SL-RU/svelotracker/pinout.xls

MCU_PIN | NAME
PA0 | K_WKUP | Sleep/wake up button
PA1 | P_VUIN | Voltage on USB
PA2 | P_IUIN | Current from USB to circuit
PA3 | P_VBAT | Voltage on batteries
PA4 | P_ISCH | Current from battaries to circuit
PA5 | L_SCK | LCD SPI
PA6 | L_MISO | LCD SPI
PA7 | L_MOSI | LCD SPI
PA8 | P_CHEN | Enable charging
PA9 | U_VBUS | USB
PA10 | U_ID | USB
PA11 | U_DM | USB
PA12 | U_DP | USB
PA13 | SWDIO | SWD debug
PA14 | SWCLK | SWD debug
PA15 | P_5VEN | Enable 5V booster & power on USB Vbus
PB0 | L_CS | LCD SPI CS
PB1 | L_LED | LCD Backlight
PB2 | P_STAT | Status of charger
PB3 | K_LATCH | Register SPI
PB4 | K_CLK | Register SPI
PB5 | K_DAT | Register SPI
PB6 | D_RX | Debug uart
PB7 | D_TX | Debug uart
PB8 | I2C1_SCL | I2C for EEPROM & COMPASS
PB9 | I2C1_SDA | I2C for EEPROM & COMPASS
PB10 | x
PB12 | C_INT2 | Compass
PB13 | C_RES | Compass
PB14 | C_INT1 | Compass
PB15 | G_RST | GPS Reset
PC0 | K_BUT1 | Button's matrix inputs
PC1 | K_BUT2 | Button's matrix inputs
PC2 | P_UFLT | USB power driver fault
PC3 | P_SHDN | Device shutdown trigger
PC4 | L_DC | LCD Data/Control
PC5 | L_RST | LCD Reset
PC6 | G_RX1 | GPS UART
PC7 | G_TX1 | GPS UART
PC8 | S_D0 | SD CARD
PC9 | S_D1 | SD CARD
PC10 | S_D2 | SD CARD
PC11 | S_D3 | SD CARD
PC12 | S_CLK | SD CARD
PC13 | x
PC14 | sys
PC15 | sys
D2 | S_CMD | SD CARD
