SL-RU/svelotracker/img/pcb1.png

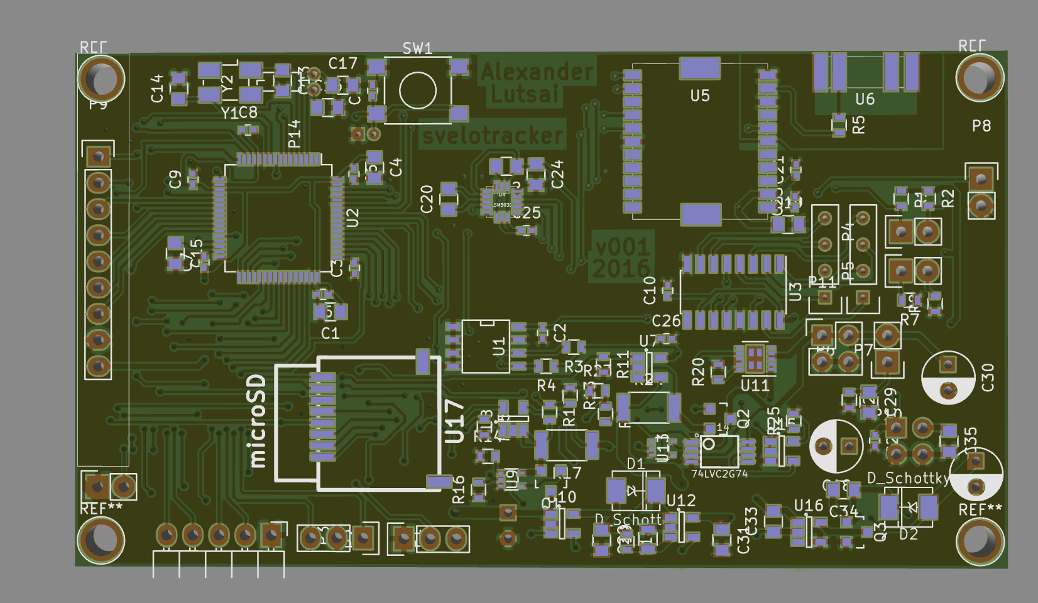
img/pcb1.png
