SL-RU/svelotracker/img/pcb2.png

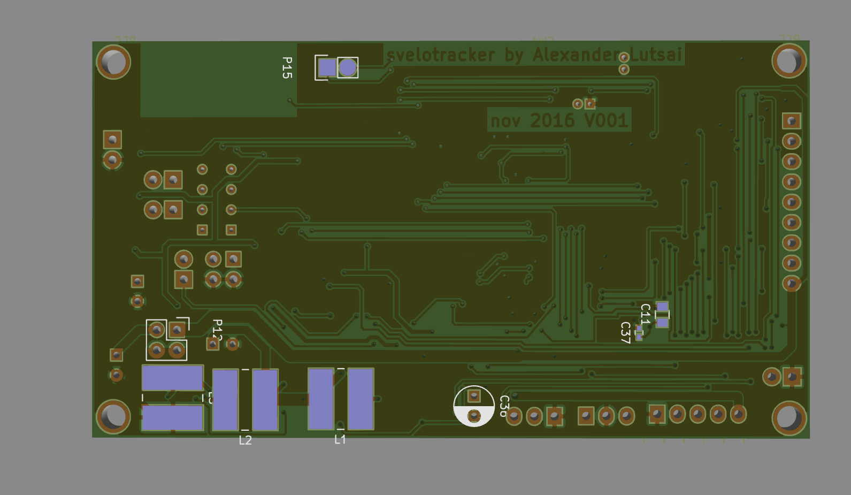
img/pcb2.png
