SL-RU/svelotracker/img/pcb3.png

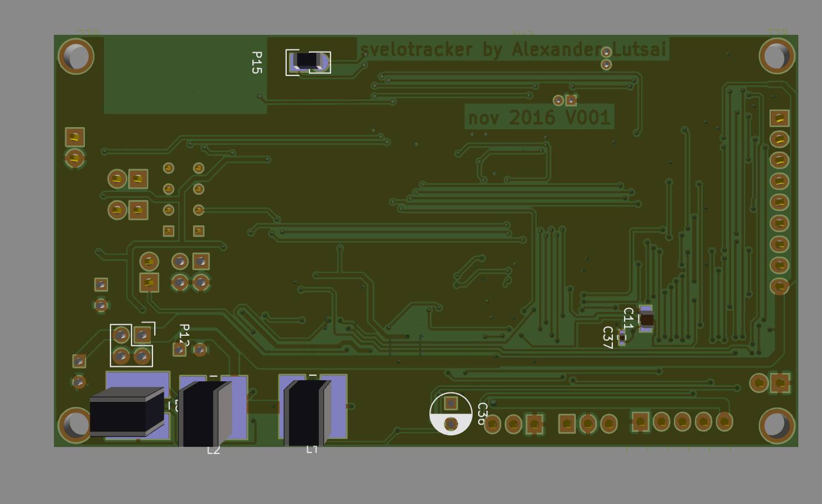
img/pcb3.png
