SL-RU/svelotracker/img/pcb4.png

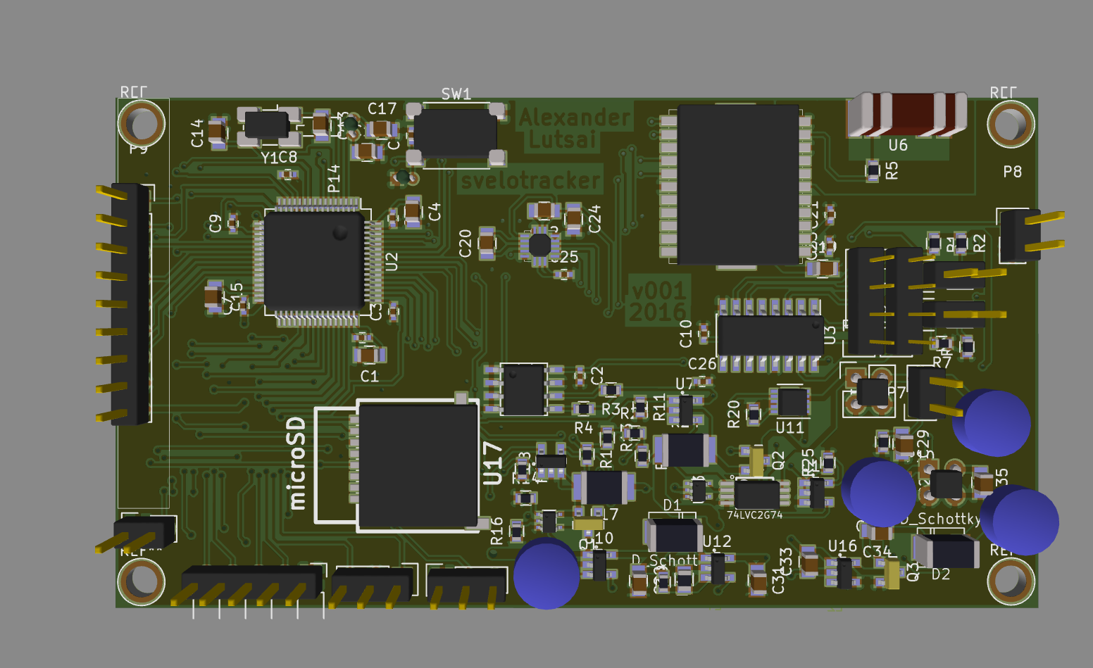
img/pcb4.png
