SL-RU/svelotracker/case/velotracker_microusb.stl

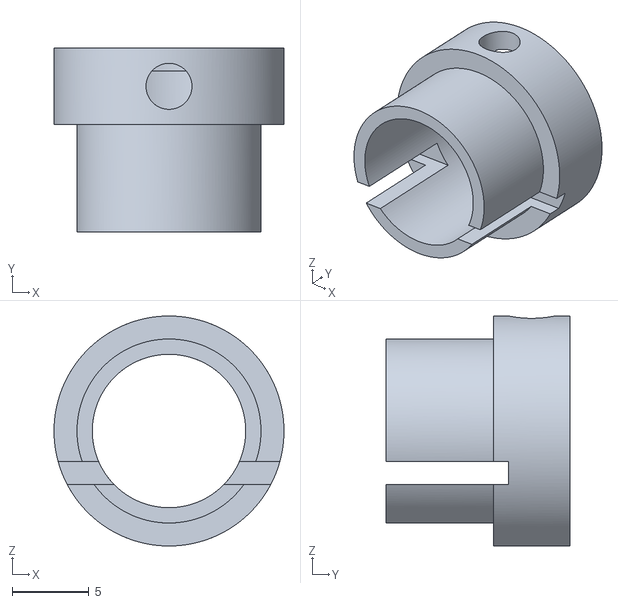
[picture p5: CAD file, 2017-02-20]
case/velotracker_microusb.stl
15.0 x 12.0 x 15.0
