SL-RU/svelotracker/datasheets/svelotracker2.stl

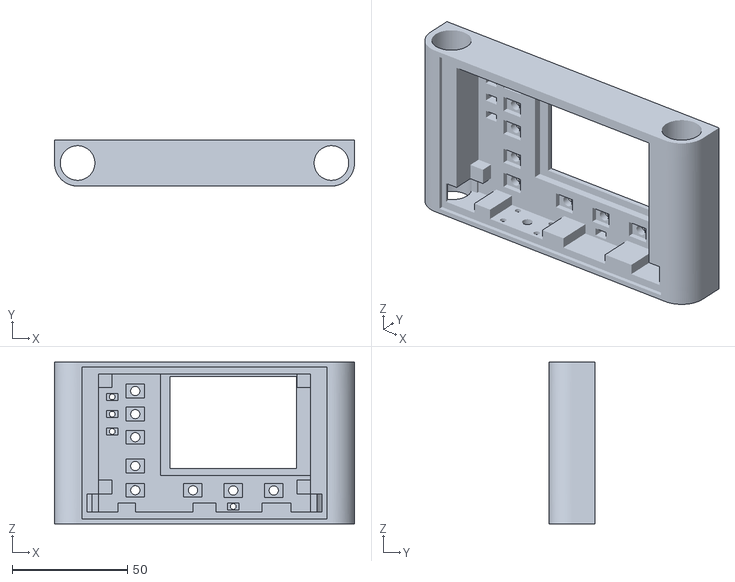
[picture p6: CAD file, 2017-02-20]
datasheets/svelotracker2.stl
130.0 x 20.0 x 70.0
