SL-RU/svelotracker/datasheets/velotracker.stl

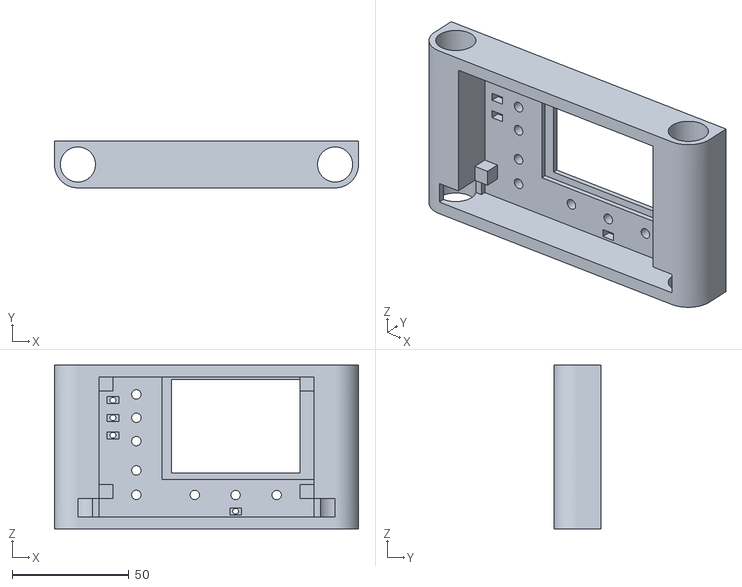
[picture p7: CAD file, 2017-02-20]
datasheets/velotracker.stl
130.0 x 20.0 x 70.0
