SL-RU/svelotracker/sch/sch.kicad_pcb

## KiCad design sch/sch.kicad_pcb (2017-02-20)

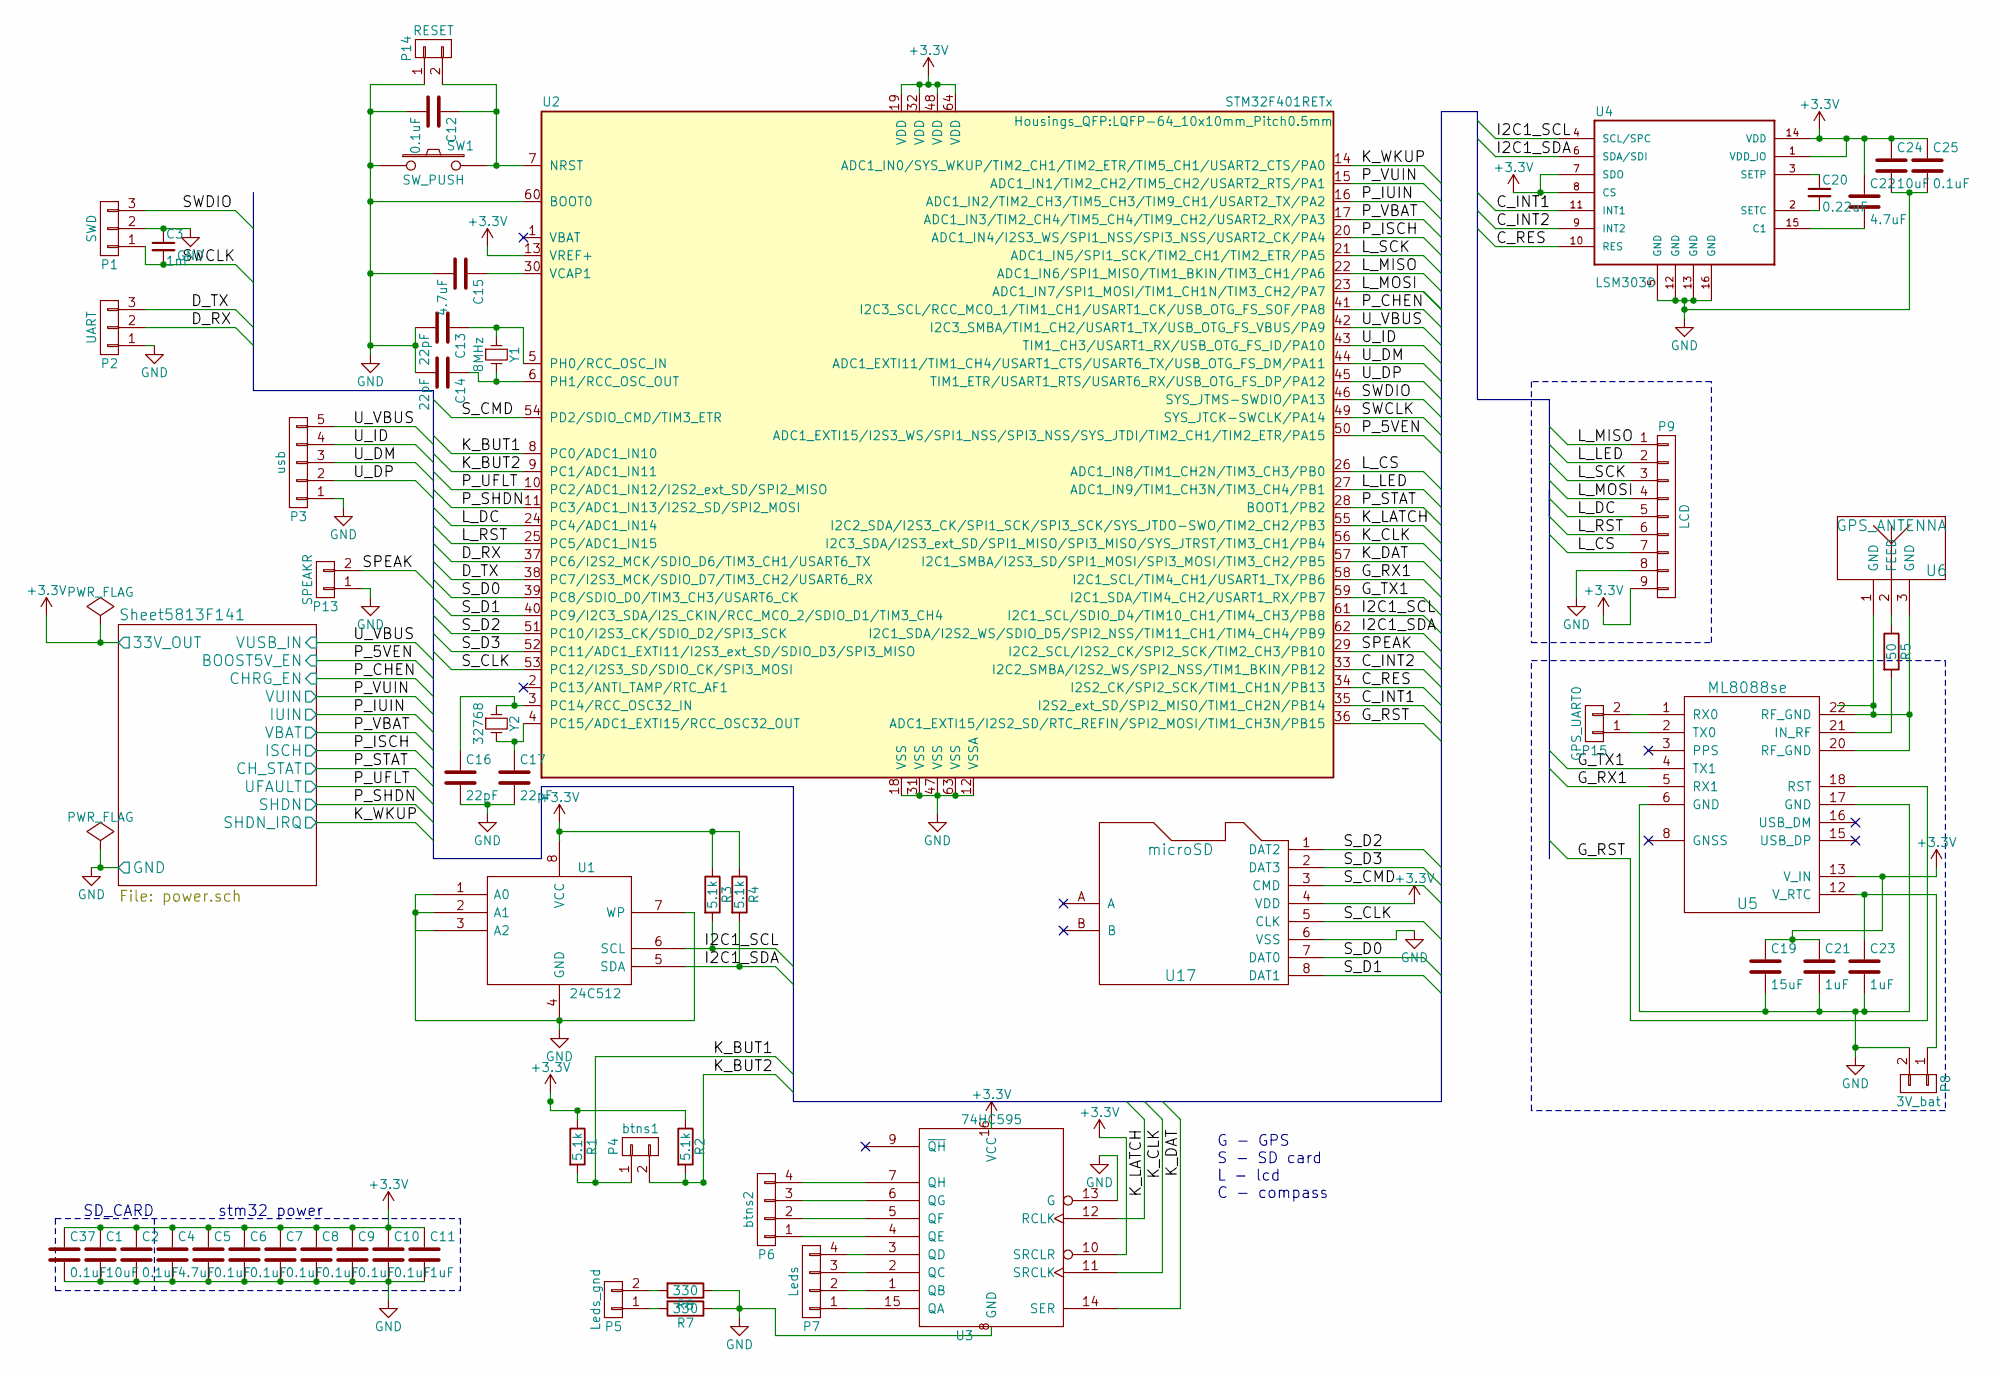
[picture p8: schematic sch.sch, svelotracker scheme]

Parts:
C1, C24: 10uF; C_0805
C2, C5, C6, C7, C8, C9, C10, C12, C25, C37: 0.1uF; C_0402
C3: 1nF; C_0402
C4, C15, C22: 4.7uF; C_0805
C11: 1uF; C_0805
C13, C14, C16, C17: 22pF; C_0805
C19: 15uF; C_0805
C20: 0.22uF; C_0805
C21, C23: 1uF; C_0402
P1: SWD; Pin_Header_Straight_1x03
P2: UART; Pin_Header_Straight_1x03
P3: usb; Pin_Header_Angled_1x05
P4: btns1; Pin_Header_Straight_1x02
P5: Leds_gnd; Pin_Header_Straight_1x02
P6: btns2; Pin_Header_Straight_1x04
P7: Leds; Pin_Header_Straight_1x04
P8: 3V_bat; Pin_Header_Straight_1x02
P9: LCD; Pin_Header_Straight_1x09
P13: SPEAKR; Pin_Header_Straight_1x02
P14: RESET; Pin_Header_Straight_1x02
P15: GPS_UART0; Pin_Header_Straight_1x02
R1, R2, R3, R4: 5.1k; R_0603
R5: 50; R_0603
R7, R8: 330; R_0603
SW1: SW_PUSH; SW_SPST_PTS645
U1: 24C512; SOIC-8-N
U2: STM32F401RETx; LQFP-64_10x10mm_Pitch0.5mm
U3: 74HC595; SOIC-16_3.9x9.9mm_Pitch1.27mm
U4: LSM303D; LGA-16-3x3
U5: ML8088se; ML8088sE
U6: GPS_ANTENNA; GSP_ANTENNA
U17: microSD; DM3D-SF
Y1: 8MHz; Crystal_SMD_5032_4Pads
Y2: 32768; Crystal_Round_Horizontal_2mm

Connections:
+3V3: C1.1, C2.1, C4.1, C5.1, C6.1, C7.1, C8.1, C9.1, C10.1, C11.1, C19.1, C21.1, C22.1, C24.1, C25.1, C37.1, P9.9, R1.1, R2.1, R3.1, R4.1, U1.8 (VCC), U2.13 (VREF+), U2.19 (VDD), U2.32 (VDD), U2.48 (VDD), U2.64 (VDD), U3.10 (SRCLR), U3.16 (VCC), U4.1 (VDD_IO), U4.7 (SDO), U4.8 (CS), U4.14 (VDD), U5.13 (V_IN), U17.4 (VDD); also elsewhere on the board
/C_INT1: U2.35 (I2S2_ext_SD/SPI2_MISO/TIM1_CH2N/PB14), U4.11 (INT1)
/C_INT2: U2.33 (I2C2_SMBA/I2S2_WS/SPI2_NSS/TIM1_BKIN/PB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), U4.9 (INT2)
/C_RES: U2.34 (I2S2_CK/SPI2_SCK/TIM1_CH1N/PB13), U4.10 (RES)
/D_RX: P2.2, U2.37 (PC6/I2S2_MCK/SDIO_D6/TIM3_CH1/USART6_TX)
/D_TX: P2.3, U2.38 (PC7/I2S3_MCK/SDIO_D7/TIM3_CH2/USART6_RX)
/G_RST: U2.36 (ADC1_EXTI15/I2S2_SD/RTC_REFIN/SPI2_MOSI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), U5.18 (RST)
/G_RX1: U2.58 (I2C1_SCL/TIM4_CH1/USART1_TX/PB6), U5.5 (RX1)
/G_TX1: U2.59 (I2C1_SDA/TIM4_CH2/USART1_RX/PB7), U5.4 (TX1)
/I2C1_SCL: R3.2, U1.6 (SCL), U2.61 (I2C1_SCL/SDIO_D4/TIM10_CH1/TIM4_CH3/PB8), U4.4 (SCL/SPC)
/I2C1_SDA: R4.2, U1.5 (SDA), U2.62 (I2C1_SDA/I2S2_WS/SDIO_D5/SPI2_NSS/TIM11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), U4.6 (SDA/SDI)
/K_BUT1: P4.1, R1.2, U2.8 (PC0/ADC1_IN10)
/K_BUT2: P4.2, R2.2, U2.9 (PC1/ADC1_IN11)
/K_CLK: U2.56 (I2C3_SDA/I2S3_ext_SD/SPI1_MISO/SPI3_MIS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), U3.11 (SRCLK)
/K_DAT: U2.57 (I2C1_SMBA/I2S3_SD/SPI1_MOSI/SPI3_MOSI/T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), U3.14 (SER)
/K_LATCH: U2.55 (I2C2_SDA/I2S3_CK/SPI1_SCK/SPI3_SCK/SYS_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), U3.12 (RCLK)
/L_CS: P9.7, U2.26 (ADC1_IN8/TIM1_CH2N/TIM3_CH3/PB0)
/L_DC: P9.5, U2.24 (PC4/ADC1_IN14)
/L_LED: P9.2, U2.27 (ADC1_IN9/TIM1_CH3N/TIM3_CH4/PB1)
/L_MISO: P9.1, U2.22 (ADC1_IN6/SPI1_MISO/TIM1_BKIN/TIM3_CH1/P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)
/L_MOSI: P9.4, U2.23 (ADC1_IN7/SPI1_MOSI/TIM1_CH1N/TIM3_CH2/P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)
/L_RST: P9.6, U2.25 (PC5/ADC1_IN15)
/L_SCK: P9.3, U2.21 (ADC1_IN5/SPI1_SCK/TIM2_CH1/TIM2_ETR/PA5)
/SPEAK: P13.2, U2.29 (I2C2_SCL/I2S2_CK/SPI2_SCK/TIM2_CH3/PB10)
/SWCLK: C3.2, P1.1, U2.49 (SYS_JTCK-SWCLK/PA14)
/SWDIO: P1.3, U2.46 (SYS_JTMS-SWDIO/PA13)
/S_CLK: U2.53 (PC12/I2S3_SD/SDIO_CK/SPI3_MOSI), U17.5 (CLK)
/S_CMD: U2.54 (PD2/SDIO_CMD/TIM3_ETR), U17.3 (CMD)
/S_D0: U2.39 (PC8/SDIO_D0/TIM3_CH3/USART6_CK), U17.7 (DAT0)
/S_D1: U2.40 (PC9/I2C3_SDA/I2S_CKIN/RCC_MCO_2/SDIO_D1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), U17.8 (DAT1)
/S_D2: U2.51 (PC10/I2S3_CK/SDIO_D2/SPI3_SCK), U17.1 (DAT2)
/S_D3: U2.52 (PC11/ADC1_EXTI11/I2S3_ext_SD/SDIO_D3/SP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), U17.2 (DAT3)
/Sheet5813F141/BOOST5V_EN: U2.50 (ADC1_EXTI15/I2S3_WS/SPI1_NSS/SPI3_NSS/S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); also elsewhere on the board
/Sheet5813F141/CHRG_EN: U2.41 (I2C3_SCL/RCC_MCO_1/TIM1_CH1/USART1_CK/U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); also elsewhere on the board
/Sheet5813F141/CH_STAT: U2.28 (BOOT1/PB2); also elsewhere on the board
/Sheet5813F141/ISCH: U2.20 (ADC1_IN4/I2S3_WS/SPI1_NSS/SPI3_NSS/USAR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); also elsewhere on the board
/Sheet5813F141/IUIN: U2.16 (ADC1_IN2/TIM2_CH3/TIM5_CH3/TIM9_CH1/USA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); also elsewhere on the board
/Sheet5813F141/SHDN: U2.11 (PC3/ADC1_IN13/I2S2_SD/SPI2_MOSI); also elsewhere on the board
/Sheet5813F141/SHDN_IRQ: U2.14 (ADC1_IN0/SYS_WKUP/TIM2_CH1/TIM2_ETR/TIM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); also elsewhere on the board
/Sheet5813F141/UFAULT: U2.10 (PC2/ADC1_IN12/I2S2_ext_SD/SPI2_MISO); also elsewhere on the board
/Sheet5813F141/VBAT: U2.17 (ADC1_IN3/TIM2_CH4/TIM5_CH4/TIM9_CH2/USA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); also elsewhere on the board
/Sheet5813F141/VUIN: U2.15 (ADC1_IN1/TIM2_CH2/TIM5_CH2/USART2_RTS/P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); also elsewhere on the board
/Sheet5813F141/VUSB_IN: P3.5, U2.42 (I2C3_SMBA/TIM1_CH2/USART1_TX/USB_OTG_FS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); also elsewhere on the board
/U_DM: P3.3, U2.44 (ADC1_EXTI11/TIM1_CH4/USART1_CTS/USART6_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)
/U_DP: P3.2, U2.45 (TIM1_ETR/USART1_RTS/USART6_RX/USB_OTG_F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)
/U_ID: P3.4, U2.43 (TIM1_CH3/USART1_RX/USB_OTG_FS_ID/PA10)
GND: C1.2, C2.2, C3.1, C4.2, C5.2, C6.2, C7.2, C8.2, C9.2, C10.2, C11.2, C12.2, C13.2, C14.2, C15.2, C16.2, C17.2, C19.2, C21.2, C23.2, C24.2, C25.2, C37.2, P1.2, P2.1, P3.1, P8.2, P9.8, P13.1, P14.1, R7.1, R8.1, SW1.1, U1.1 (A0), U1.2 (A1), U1.3 (A2), U1.4 (GND), U1.7 (WP), U2.12 (VSSA), U2.18 (VSS), U2.31 (VSS), U2.47 (VSS), U2.60 (BOOT0), U2.63 (VSS), U3.8 (GND), U3.13 (G), U4.5 (GND), U4.12 (GND), U4.13 (GND), U4.16 (GND), U5.6 (GND), U5.17 (GND), U17.6 (VSS); also elsewhere on the board
unnamed: C12.1, P14.2, SW1.2, U2.7 (NRST)
unnamed: C13.1, U2.5 (PH0/RCC_OSC_IN), Y1.1
unnamed: C14.1, U2.6 (PH1/RCC_OSC_OUT), Y1.2
unnamed: C15.1, U2.30 (VCAP1)
unnamed: C16.1, U2.3 (PC14/RCC_OSC32_IN), Y2.1
unnamed: C17.1, U2.4 (PC15/ADC1_EXTI15/RCC_OSC32_OUT), Y2.2
unnamed: C20.1, U4.3 (SETP)
unnamed: C20.2, U4.2 (SETC)
unnamed: C22.2, U4.15 (C1)
unnamed: C23.1, P8.1, U5.12 (V_RTC)
unnamed: P5.1, R7.2
unnamed: P5.2, R8.2
unnamed: P6.1, U3.4 (QE)
unnamed: P6.2, U3.5 (QF)
unnamed: P6.3, U3.6 (QG)
unnamed: P6.4, U3.7 (QH)
unnamed: P7.1, U3.15 (QA)
unnamed: P7.2, U3.1 (QB)
unnamed: P7.3, U3.2 (QC)
unnamed: P7.4, U3.3 (QD)
unnamed: P15.1, U5.2 (TX0)
unnamed: P15.2, U5.1 (RX0)
unnamed: R5.1, U6.2 (FEED)
unnamed: R5.2, U5.21 (IN_RF)
unnamed: U5.20 (RF_GND), U5.22 (RF_GND), U6.1 (GND), U6.3 (GND)

Notes on the sheet:
G - GPS S - SD card L - lcd C - compass
stm32 power
SD_CARD

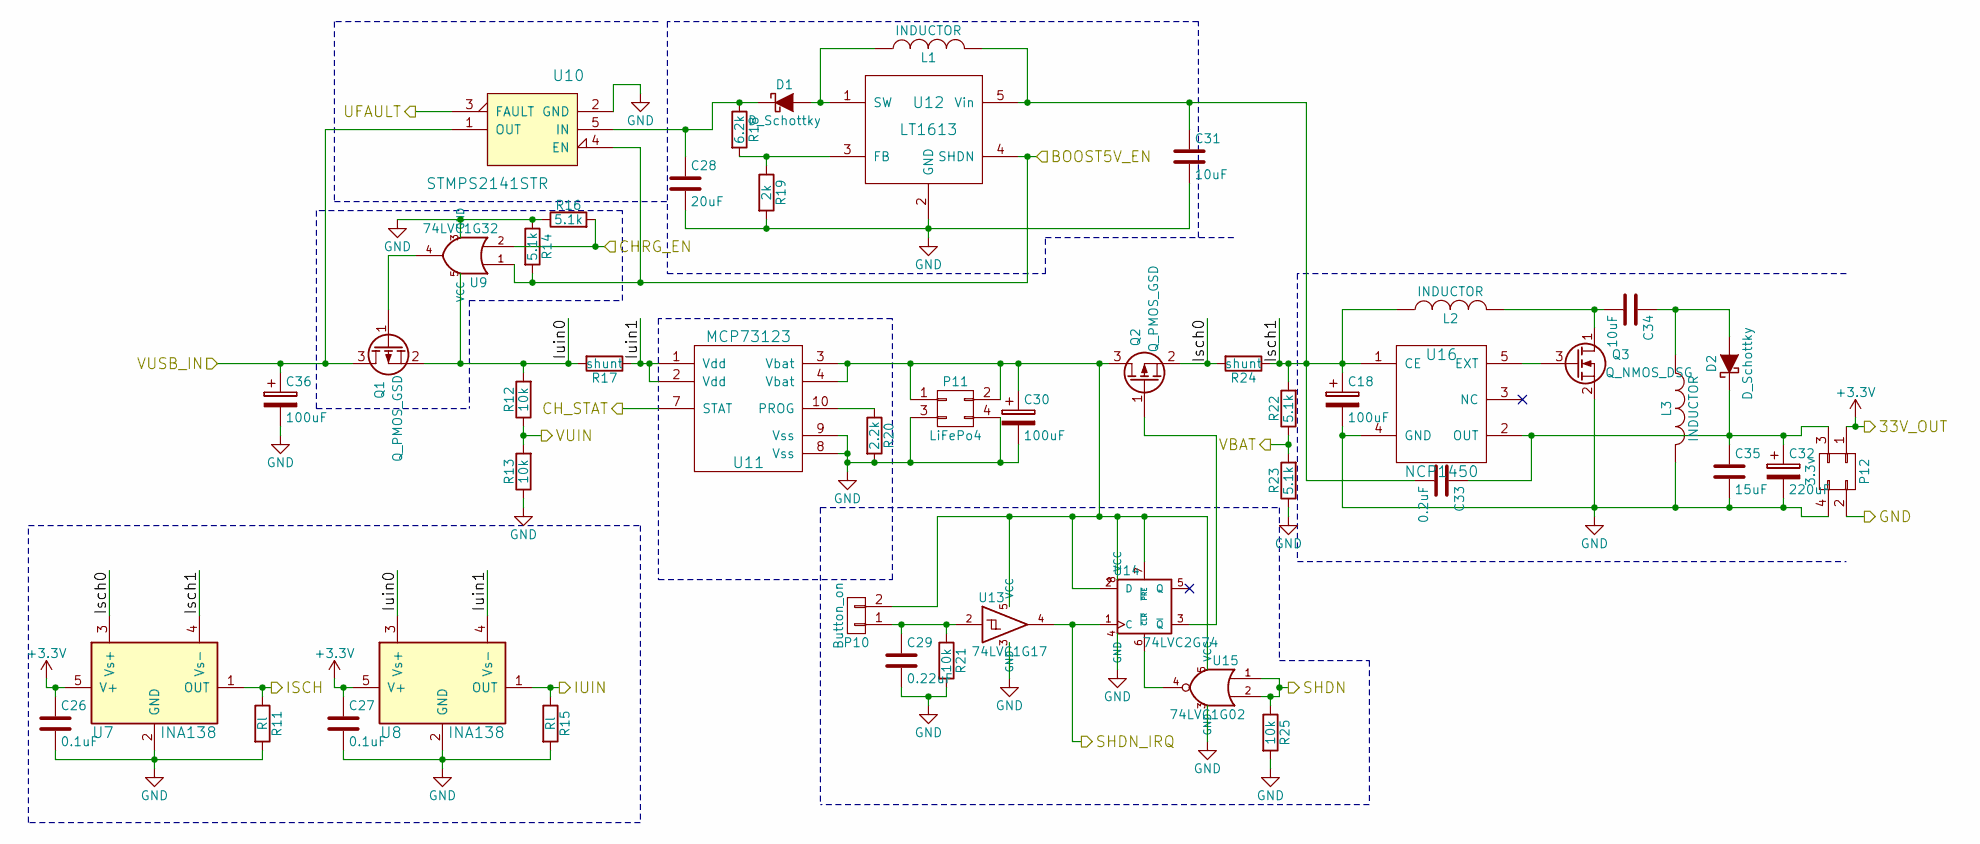
[picture p9: schematic power.sch, Power scheme for velotracker]

Parts:
C18, C30, C36: 100uF; C_Radial_D5_L11_P2.5
C26, C27: 0.1uF; C_0402
C28: 20uF; C_0805
C29: 0.22uF; C_0805
C31, C34: 10uF; C_0805
C32: 220uF; C_Radial_D5_L11_P2.5
C33: 0.2uF; C_0805
C35: 15uF; C_0805
D1, D2: D_Schottky; DO-214AC(SMA)
L1, L2, L3: INDUCTOR; Choke_SMD_Wuerth-WE-PD2-Typ-L
P10: Button_on; Pin_Header_Straight_1x02
P11: LiFePo4; Pin_Header_Straight_2x02
P12: 3.3v; Pin_Header_Straight_2x02
Q1, Q2: Q_PMOS_GSD; SOT-23
Q3: Q_NMOS_DSG; SOT-23
R11, R15: Rl; R_0603
R12, R13, R21, R25: 10k; R_0603
R14, R16, R22, R23: 5.1k; R_0603
R17, R24: shunt; R_2010
R18: 6.2k; R_0603
R19: 2k; R_0805
R20: 2.2k; R_0603
U7, U8: INA138; SOT-23-5
U9: 74LVC1G32; SOT-353
U10: STMPS2141STR; SOT-23-5
U11: MCP73123; DFN-10-1EP_3x3mm_Pitch0.5mm
U12: LT1613; SOT-23-5
U13: 74LVC1G17; SOT-353
U14: 74LVC2G74; SSOP8
U15: 74LVC1G02; SOT-23-5
U16: NCP1450; SOT-23-5

Connections:
+3V3: C26.1, C27.1, P12.1, U7.5 (V+), U8.5 (V+); also elsewhere on the board
/Sheet5813F141/BOOST5V_EN: R14.2, U9.1, U10.4 (EN), U12.4 (SHDN); also elsewhere on the board
/Sheet5813F141/CHRG_EN: R16.2, U9.2; also elsewhere on the board
/Sheet5813F141/CH_STAT: U11.7 (STAT); also elsewhere on the board
/Sheet5813F141/ISCH: R11.1, U7.1 (OUT); also elsewhere on the board
/Sheet5813F141/IUIN: R15.1, U8.1 (OUT); also elsewhere on the board
/Sheet5813F141/Isch0: Q2.2 (S), R24.2, U7.3 (Vs+)
/Sheet5813F141/Isch1: C18.1, C31.1, C33.2, L1.2, L2.1, R22.2, R24.1, U7.4 (Vs-), U12.5 (Vin), U16.1 (CE)
/Sheet5813F141/Iuin0: Q1.2 (S), R12.2, R17.2, U8.3 (Vs+), U9.5 (VCC)
/Sheet5813F141/Iuin1: R17.1, U8.4 (Vs-), U11.1 (Vdd), U11.2 (Vdd)
/Sheet5813F141/SHDN: R25.1, U15.1, U15.2; also elsewhere on the board
/Sheet5813F141/SHDN_IRQ: U13.4, U14.1 (C); also elsewhere on the board
/Sheet5813F141/UFAULT: U10.3 (FAULT); also elsewhere on the board
/Sheet5813F141/VBAT: R22.1, R23.2; also elsewhere on the board
/Sheet5813F141/VUIN: R12.1, R13.2; also elsewhere on the board
/Sheet5813F141/VUSB_IN: C36.1, Q1.3 (D), U10.1 (OUT); also elsewhere on the board
GND: C18.2, C26.2, C27.2, C28.2, C29.2, C30.2, C31.2, C32.2, C35.2, C36.2, L3.2, P11.3, P11.4, P12.2, P12.4, Q3.2 (S), R11.2, R13.1, R14.1, R15.2, R16.1, R19.2, R20.2, R21.2, R23.1, R25.2, U7.2 (GND), U8.2 (GND), U9.3 (GND), U10.2 (GND), U11.8 (Vss), U11.9 (Vss), U12.2 (GND), U13.3 (GND), U14.4 (GND), U15.3 (GND), U16.4 (GND); also elsewhere on the board
unnamed: C28.1, D1.1 (K), R18.1, U10.5 (IN)
unnamed: C29.1, P10.1, R21.1, U13.2
unnamed: C30.1, P10.2, P11.1, P11.2, Q2.3 (D), U11.3 (Vbat), U11.4 (Vbat), U13.5 (VCC), U14.2 (D), U14.7 (~PRE), U14.8 (VCC), U15.5 (VCC)
unnamed: C32.1, C33.1, C35.1, D2.1 (K), P12.3, U16.2 (OUT)
unnamed: C34.1, D2.2 (A), L3.1
unnamed: C34.2, L2.2, Q3.1 (D)
unnamed: D1.2 (A), L1.1, U12.1 (SW)
unnamed: Q1.1 (G), U9.4
unnamed: Q2.1 (G), U14.3 (~Q)
unnamed: Q3.3 (G), U16.5 (EXT)
unnamed: R18.2, R19.1, U12.3 (FB)
unnamed: R20.1, U11.10 (PROG)
unnamed: U14.6 (~CLR), U15.4

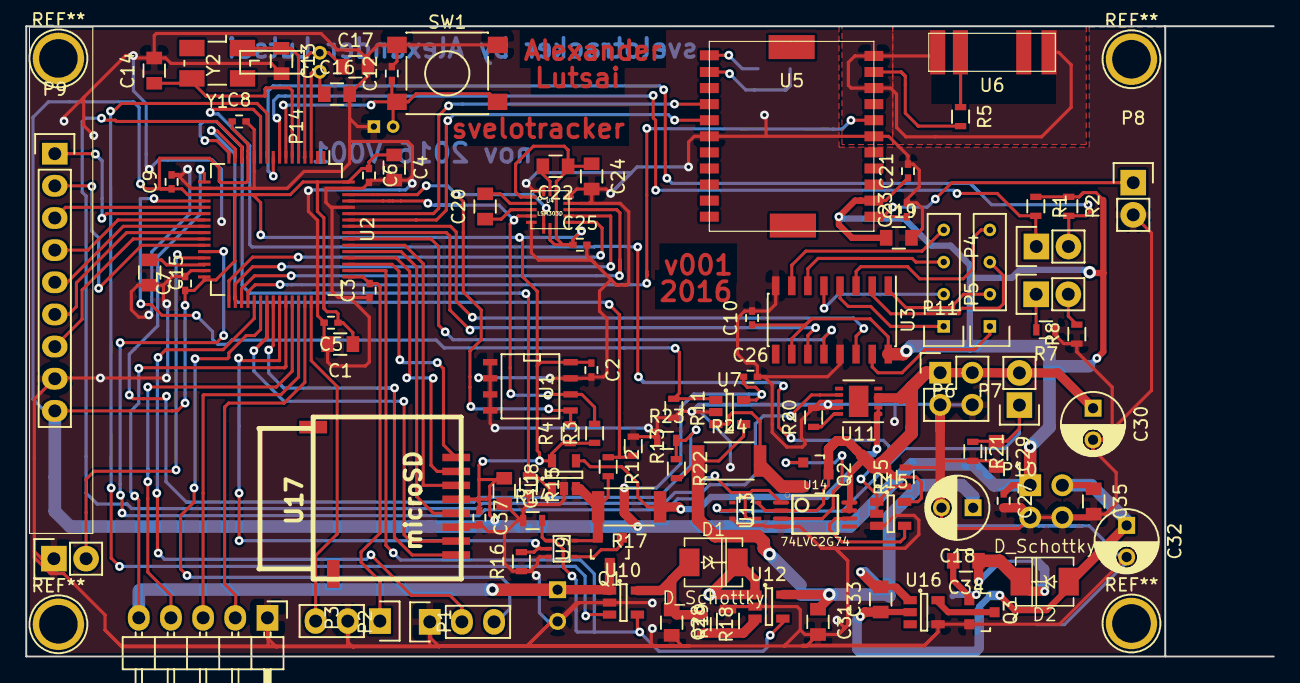
[picture p10: board sch.kicad_pcb from above]

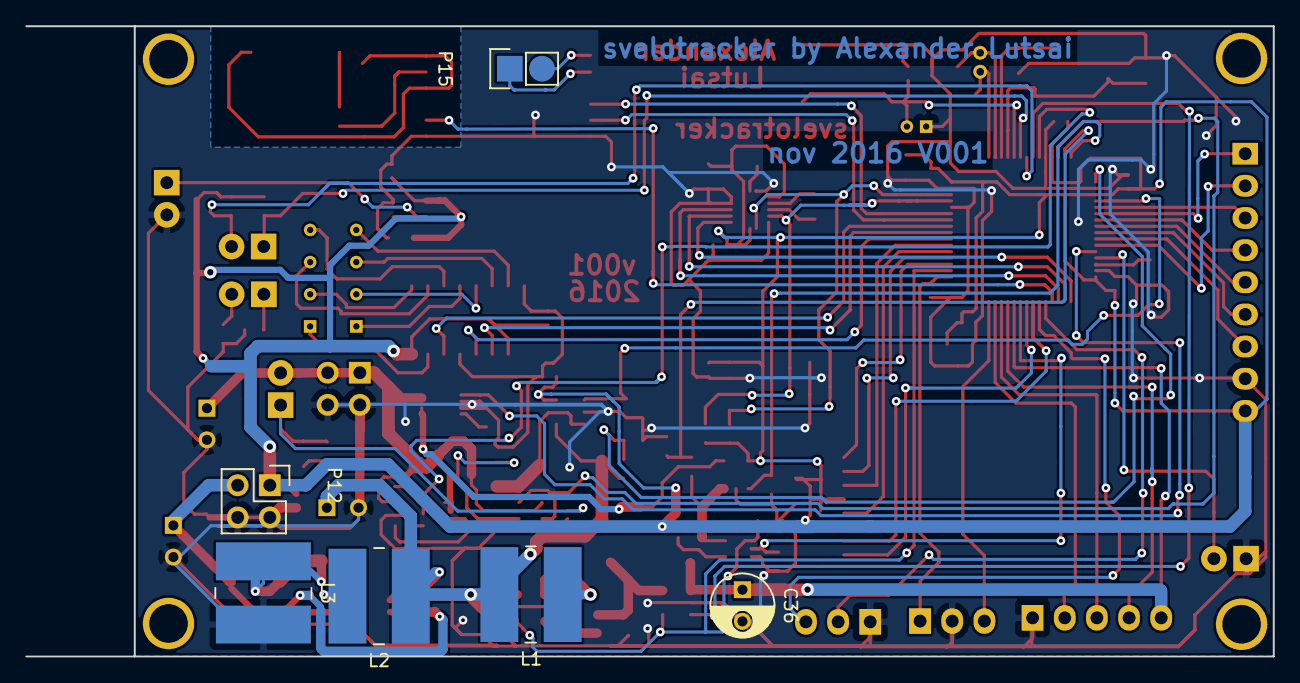
[picture p11: board sch.kicad_pcb from below]

Board: 2 copper layers, 98.6 x 49.8 mm, 102 parts (6 on the bottom side), 89 nets.
