SL-RU/svelotracker/sch/lcd_dc-dc/lcddc.kicad_pcb

## KiCad design sch/lcd_dc-dc/lcddc.kicad_pcb (2017-02-20)

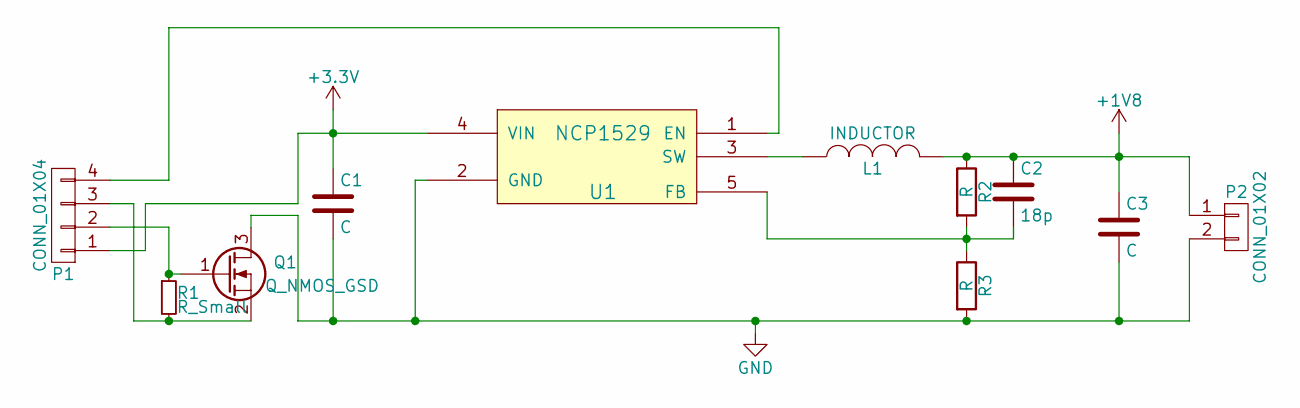
[picture p12: schematic lcddc.sch]

Parts:
C1, C3: C; C_0805_HandSoldering
C2: 18p; C_0805_HandSoldering
L1: INDUCTOR; CDRH2D14
P1: CONN_01X04; Pin_Header_Straight_1x04
P2: CONN_01X02; Pin_Header_Straight_1x02
Q1: Q_NMOS_GSD; SOT-23
R1: R_Small; R_0603_HandSoldering
R2, R3: R; R_0603_HandSoldering
U1: NCP1529; SOT-23-5

Connections:
+1V8: C2.1, C3.1, L1.2, P2.1, R2.1
+3V3: C1.1, P1.1, U1.4 (VIN)
GND: C1.2, C3.2, P2.2, Q1.3 (D), R3.2, U1.2 (GND)
unnamed: C2.2, R2.2, R3.1, U1.5 (FB)
unnamed: L1.1, U1.3 (SW)
unnamed: P1.2, Q1.1 (G), R1.1
unnamed: P1.3, Q1.2 (S), R1.2
unnamed: P1.4, U1.1 (EN)

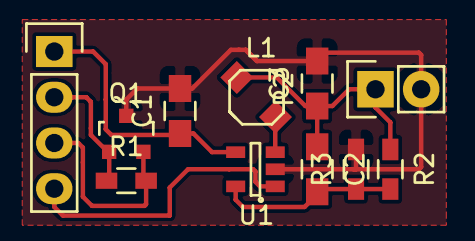
[picture p13: board lcddc.kicad_pcb from above]

Board: 2 copper layers, 11 parts (0 on the bottom side), 8 nets.
