SL-RU/svelotracker/src/test/gps_test/gps_test.ioc

Mcu.UserName=STM32F401RETx
PA0-WKUP.Signal=SYS_WKUP
PA13.Signal=SYS_JTMS-SWDIO
PA14.Signal=SYS_JTCK-SWCLK
PA5.Signal=SPI1_SCK
PA6.Signal=SPI1_MISO
PA7.Signal=SPI1_MOSI
PB0.GPIO_Label=l_cs
PB0.Signal=GPIO_Output
PB1.Signal=S_TIM3_CH4
PB10.Signal=GPIO_Output
PB12.Signal=GPXTI12
PB14.Signal=GPXTI14
PB15.GPIO_Label=G_RST
PB15.Signal=GPIO_Output
PB3.GPIO_Label=k_latch
PB3.Signal=GPIO_Output
PB4.GPIO_Label=k_clk
PB4.Signal=GPIO_Output
PB5.GPIO_Label=k_DAT
PB5.Signal=GPIO_Output
PB6.GPIO_Label=G_RX1
PB6.Signal=USART1_TX
PB7.GPIO_Label=G_TX1
PB7.Signal=USART1_RX
PB8.Signal=I2C1_SCL
PB9.Signal=I2C1_SDA
PC0.Signal=GPIO_Input
PC1.Signal=GPIO_Input
PC10.Signal=SDIO_D2
PC11.Signal=SDIO_D3
PC12.Signal=SDIO_CK
PC4.GPIO_Label=l_dc
PC4.Signal=GPIO_Output
PC5.GPIO_Label=l_rst
PC5.Signal=GPIO_Output
PC6.Signal=USART6_TX
PC7.Signal=USART6_RX
PC8.Signal=SDIO_D0
PC9.Signal=SDIO_D1
PD2.Signal=SDIO_CMD
