SL-RU/svelotracker/src/test/gps_test/dev/compass.c

#include "compass.h"

uint8_t compass_register_read(uint8_t reg)
{
    uint8_t result = 0;
    HAL_I2C_Master_Transmit(&COMPASS_I2C, COMPASS_I2C_ADDR, &reg,    1, 100);
    HAL_I2C_Master_Receive(&COMPASS_I2C,  COMPASS_I2C_ADDR, &result, 1, 100);
    return result;
}
void compass_register_write(uint8_t reg, uint8_t data)
{
    uint8_t d[] = {reg, data};
    HAL_I2C_Master_Transmit(&COMPASS_I2C, COMPASS_I2C_ADDR, d, 2, 100);
}

float ang = 0;
void HAL_GPIO_EXTI_Callback(uint16_t GPIO_Pin)
{
}

double pitch_a,
  roll_a;

void c_a()
{
  uint8_t mag[6];
  uint8_t reg = LSM303_OUT_X_L_A | (1<<7);
  HAL_I2C_Master_Transmit(&COMPASS_I2C, COMPASS_I2C_ADDR, &reg, 1, 100);
  HAL_I2C_Master_Receive(&COMPASS_I2C, COMPASS_I2C_ADDR, mag, 6, 100);
  int x = (int16_t)((mag[1] << 8) | mag[0]);
  int y = (int16_t)((mag[3] << 8) | mag[2]);
  int z = (int16_t)((mag[5] << 8) | mag[4]);

  pitch_a = atan2(x, sqrt(y*y + z*z));
  roll_a  = atan2(-y, z);

  printf("acc %05d %05d %05\n", x, y, z);
  //  printf("acc %03d %03d\n", (int)(pitch_a * 180 / 3.1415), (int)(roll_a * 180 / 3.1415));
}
void c_u()
{
//    printf("GPIO 12 EXTI\n");
    uint8_t mag[6];
    uint8_t reg = LSM303_OUT_X_L_M | (1<<7);
    HAL_I2C_Master_Transmit(&COMPASS_I2C, COMPASS_I2C_ADDR, &reg, 1, 100);
    HAL_I2C_Master_Receive(&COMPASS_I2C, COMPASS_I2C_ADDR, mag, 6, 100);
    int x = (int16_t)((mag[1] << 8) | mag[0]);
    int y = (int16_t)((mag[3] << 8) | mag[2]);
    int z = (int16_t)((mag[5] << 8) | mag[4]);

    
    double
      pitch = atan2(x, sqrt(y*y + z*z)),
      roll  =  - atan2(y, -x),
      yaw   = atan2(z, sqrt(x*x + y*y));

    float headX;
    float headY;
    float cos_roll;
    float sin_roll;
    float cos_pitch;
    float sin_pitch;


    ang = (float)roll;
    printf("mag %05d %05d %05d\n", x, y, z);
    


    
    // Declination correction (if supplied)
    /* if( fabs(_declination) > 0.0 ) */
    /* { */
        /* heading = heading + _declination; */
        /* if (heading > M_PI)    // Angle normalization (-180 deg, 180 deg) */
        /*     heading -= (2.0 * M_PI); */
        /* else if (heading < -M_PI) */
        /*     heading += (2.0 * M_PI); */
//    }

    // Optimization for external DCM use. Calculate normalized components
//    heading_x = cos(heading);
//    heading_y = sin(heading);
    
//    printf("%f\n", ang);

}

void compass_init()
{
//  Magnetometer data-ready signal on INT1 enable
  compass_register_write(LSM303_CTRL1,      0x57);
  compass_register_write(LSM303_CTRL2,      0x00);
    /* compass_register_write(LSM303_CTRL3,      0b11001010); */
    /* compass_register_write(LSM303_CTRL4,      0b00010100); */
    /* compass_register_write(LSM303_INT_CTRL_M, 0b00000000); */
    
/* CTRL5 register description */
/*  TEMP_EN Temperature sensor enable. Default value: 0 */
/* (0: temperature sensor disabled; 1: temperature sensor enabled) */
/* M_RES [1:0] Magnetic resolution selection. Default value: 00 */
/* (00: low resolution, 11: high resolution) */
/* M_ODR [2:0] Magnetic data rate selection. Default value: 110 */
/* Refer to Table 47 */
/* LIR2 Latch interrupt request on INT2_SRC register, with INT2_SRC register cleared by */
/* reading INT2_SRC itself. Default value: 0. */
/* (0: interrupt request not latched; 1: interrupt request latched) */
/* LIR1 Latch interrupt request on INT1_SRC register, with INT1_SRC register cleared by */
/* reading INT1_SRC itself. Default value: 0. */
/* (0: interrupt request not latched; 1: interrupt request latched) */
    compass_register_write(LSM303_CTRL5, 0b01101000);
    
/* CTRL6 register description */
/* MFS [1:0] */
/* Magnetic full-scale selection. Default value: 01 */
/* Refer to Table 50 */
    compass_register_write(LSM303_CTRL6, 0x20);
    
/* CTRL7 register description */
/* AHPM[1:0] High-pass filter mode selection for acceleration data. Default value: 00 */
/* Refer to Table 53 */
/* AFDS Filtered acceleration data selection. Default value: 0 */
/* (0: internal filter bypassed; 1: data from internal filter sent to output register and FIFO) */
/* T_ONLY Temperature sensor only mode. Default value: 0 */
/* If this bit is set to ‘1’, the temperature sensor is on while the magnetic sensor is off. */
/* MLP Magnetic data low-power mode. Default value: 0 */
/* If this bit is ‘1’, the M_ODR [2:0] is set to 3.125 Hz independently from the MODR set- */
/* tings. Once the bit is set to ‘0’, the magnetic data rate is configured by the MODR bits */
/* in the CTRL5 (24h) register. */
/* MD[1:0] Magnetic sensor mode selection. Default 10 */
/* Refer to Table 54 */
    compass_register_write(LSM303_CTRL7, 0b000000);


    printf("acc %d\n", compass_register_read(LSM303_WHO_AM_I));

    
    for (int i = 0; i < 100000; i++) {
    
      c_a();
    //HAL_GPIO_EXTI_Callback(0);
/////    lsm303_read();
///
      HAL_Delay(15);
      c_u();
      HAL_Delay(15);
      
    }
}

float* compass_get_angle()
{
    return &ang;
}
