SL-RU/svelotracker/src/test/gps_test/gui/gui_custom.h

#ifndef GUI_CUSTOM_H
#define GUI_CUSTOM_H
#include "gui.h"
#include <math.h>

//compass element
typedef struct {
    MakiseGUI *gui;
    MElement el;

    float *angle;

    int32_t x;
    int32_t y;
    uint32_t r;

    MakisePoint arrow[5];
    
} MCompass;

void gui_create_compass(MCompass *b, MContainer *c,
			int32_t x, int32_t y, //position of center
			uint32_t r, //radius
			float *angle);

typedef struct {
  MakiseGUI *gui;
  MElement el;

  double *pitch,
    *roll,
    *yaw;
    

    MakisePoint arrow[5];
    
} MCube;

void gui_create_cube(MCube *b, MContainer *c,
		     int32_t x, int32_t y, //position of center
		     double *pitch,
		     double *roll,
		     double *yaw);


#endif
