SL-RU/svelotracker/(commit log)

2016-10-30 power done
    [power.sch, sch.sch]
2016-10-31 footprints done
    [pinout.xls, power.sch, sch.kicad_pcb, sch.sch]
2016-11-02 layout 60%
    [power.sch, sch.kicad_pcb, sch.sch]
2016-11-03 pcb 100%
    [sch.kicad_pcb, sch.sch]
2016-11-03 name on pcb
    [sch.kicad_pcb]
2016-11-08 pcb ready. gerber files also.
    [power.sch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]
2016-11-15 to rezonit
    [sch-B.Cu.gbl, sch-B.Mask.gbs, sch-B.Paste.gbp, sch-B.SilkS.gbo, sch-Edge.Cuts.gm1, sch-F.Cu.gtl, sch-F.Mask.gts, sch-F.Paste.gtp]
2016-11-23 sd card 180 degree rotation
    [sch-B.Cu.gbl, sch-B.Mask.gbs, sch-B.Paste.gbp, sch-Edge.Cuts.gm1, sch-F.Cu.gtl, sch-F.Mask.gts, sch-F.Paste.gtp, sch.drl]
2016-11-29 via size for rezonit
    [lcddc.kicad_pcb, lcddc.sch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]
2016-12-09 lcd dc converter fix
    [lcddc.kicad_pcb]
2017-02-20 added gps test project
    [lcddc.kicad_pcb, lcddc.sch, power.sch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]
2017-02-20 I2C test
    [_saved_sch.sch]
