SL-RU/svelotracker/(notices)

Notices in the files:
src/test/gps_test/Src/main.c:
(C) COPYRIGHT STMicroelectronics *****END OF FILE
